Makerfabs/Home-Assistant-Relay-8-Channel/md_pic/main.jpg

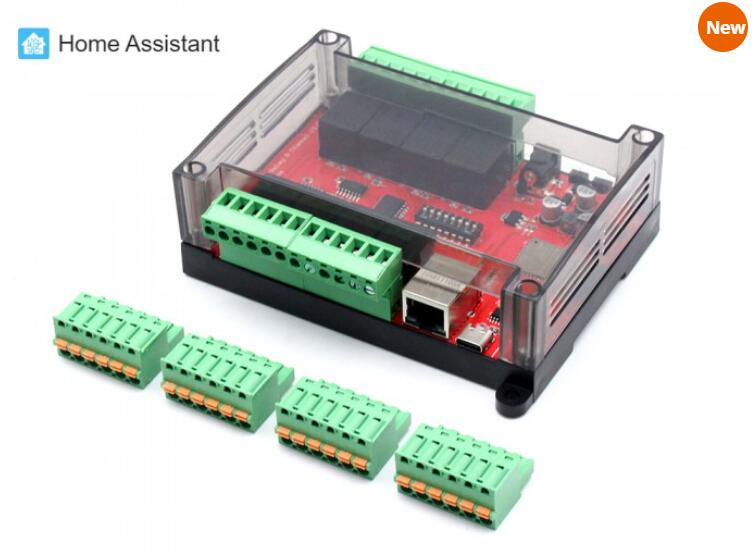
md_pic/main.jpg
