Makerfabs/Home-Assistant-Relay-8-Channel/README.md

# Makerfabs Home Assistant Relay 8 Channel

## Intruduce
[Product Link](https://www.makerfabs.com/8-channel-relay-for-home-assistant.html)

[Wiki Link](https://wiki.makerfabs.com/How-to-use-Home-Assistant-Relay-8-Channel.html)
