Makerfabs/Home-Assistant-Relay-8-Channel/md_pic/4.jpg

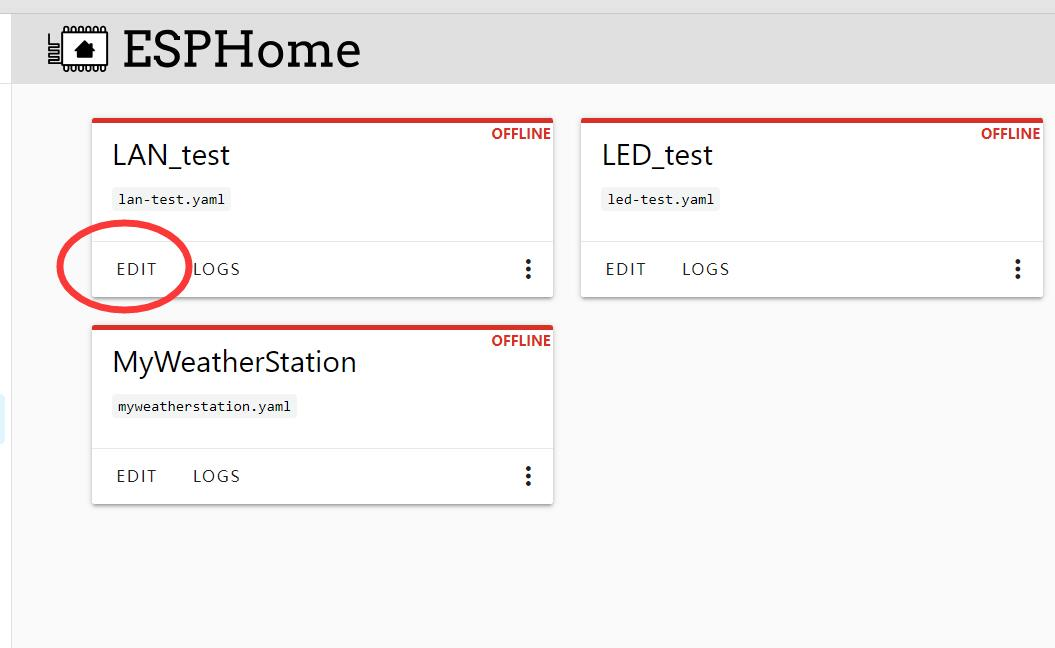
md_pic/4.jpg
