Makerfabs/Home-Assistant-Relay-8-Channel/md_pic/5.jpg

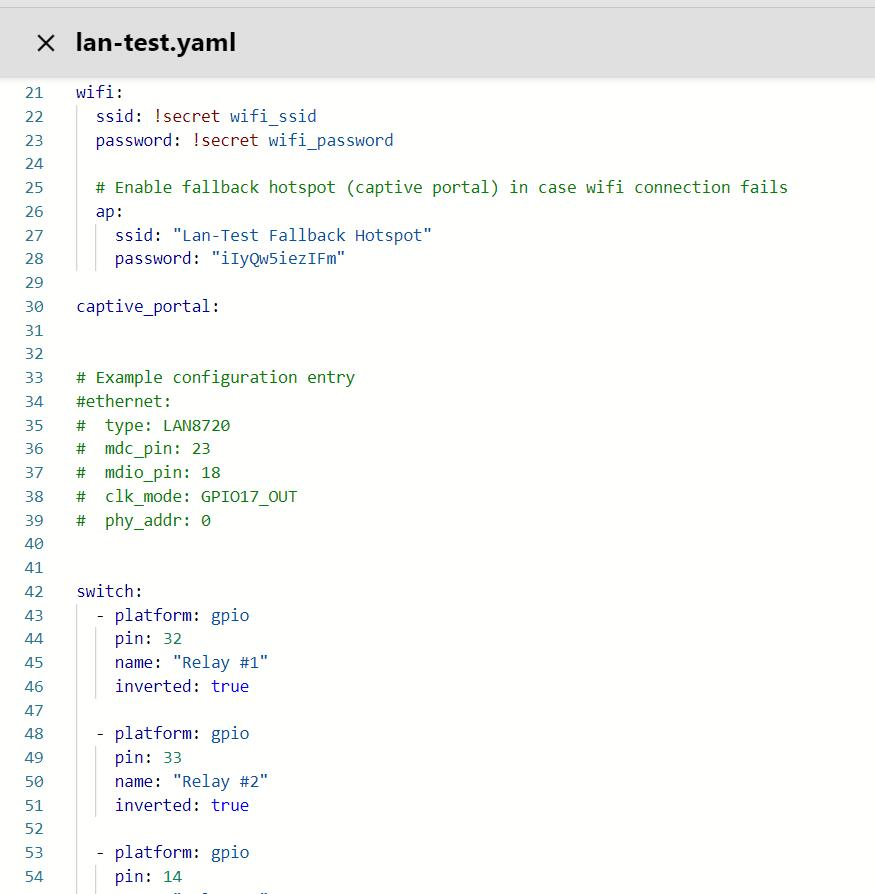
md_pic/5.jpg
