Makerfabs/Home-Assistant-Relay-8-Channel/md_pic/17.jpg

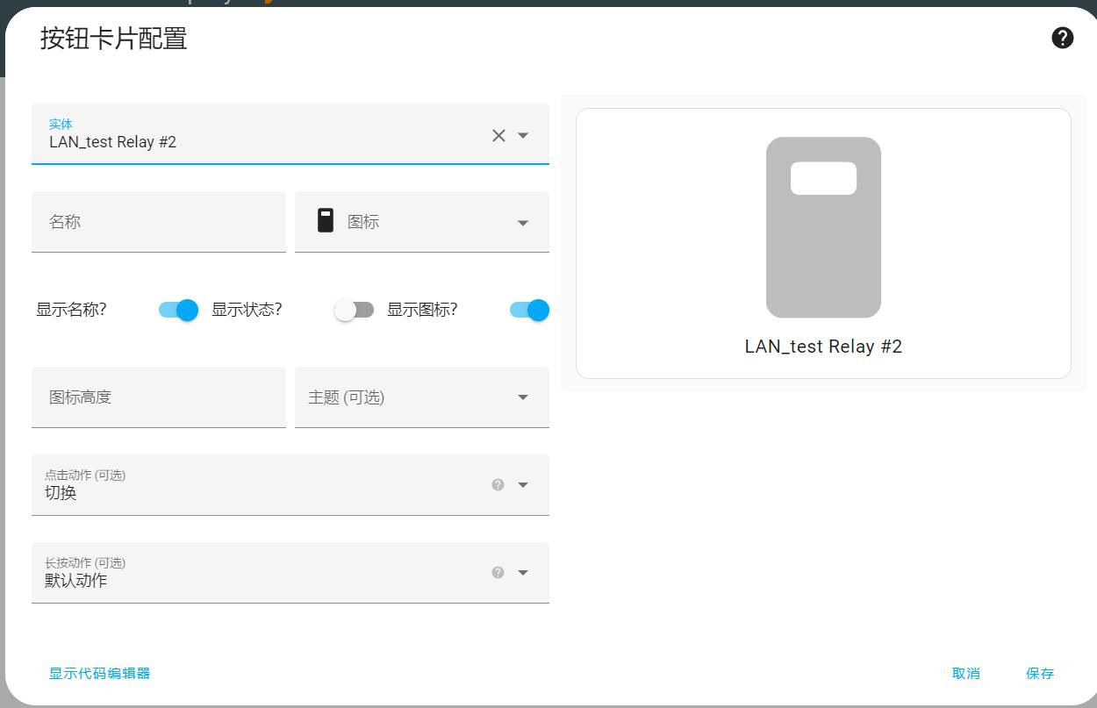
md_pic/17.jpg
