Makerfabs/Home-Assistant-Relay-8-Channel/md_pic/18.jpg

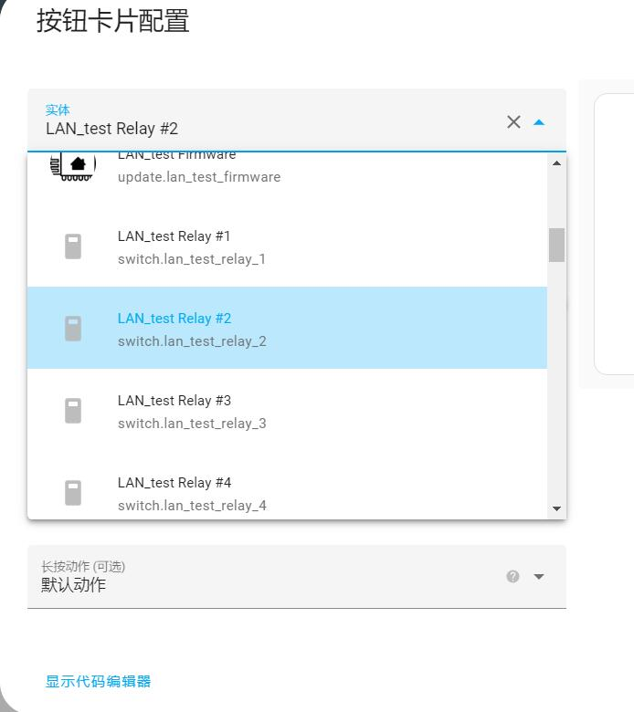
md_pic/18.jpg
