Makerfabs/Home-Assistant-Relay-8-Channel/md_pic/21.jpg

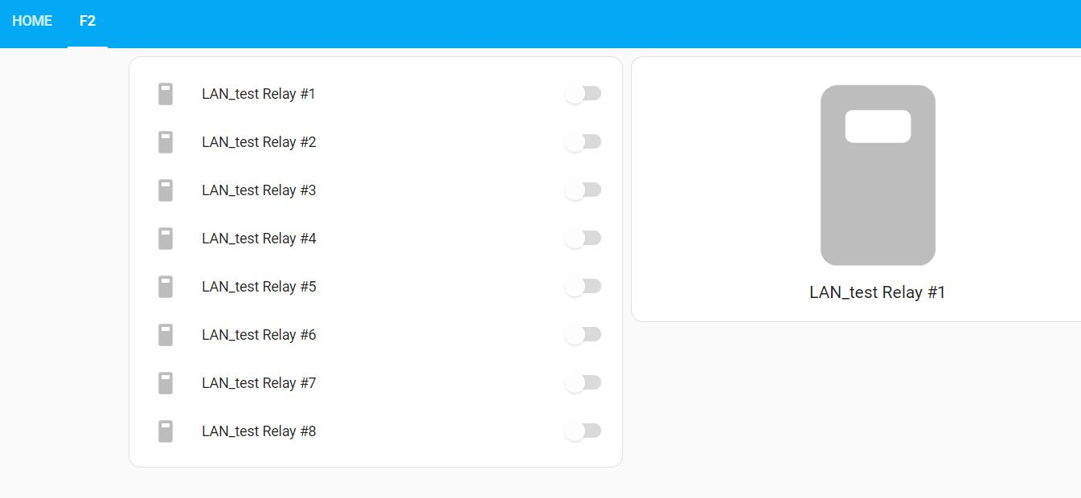
md_pic/21.jpg
