Makerfabs/Home-Assistant-Relay-8-Channel/hardware/Home Assistant Relay 8 Channel V1.2.pdf

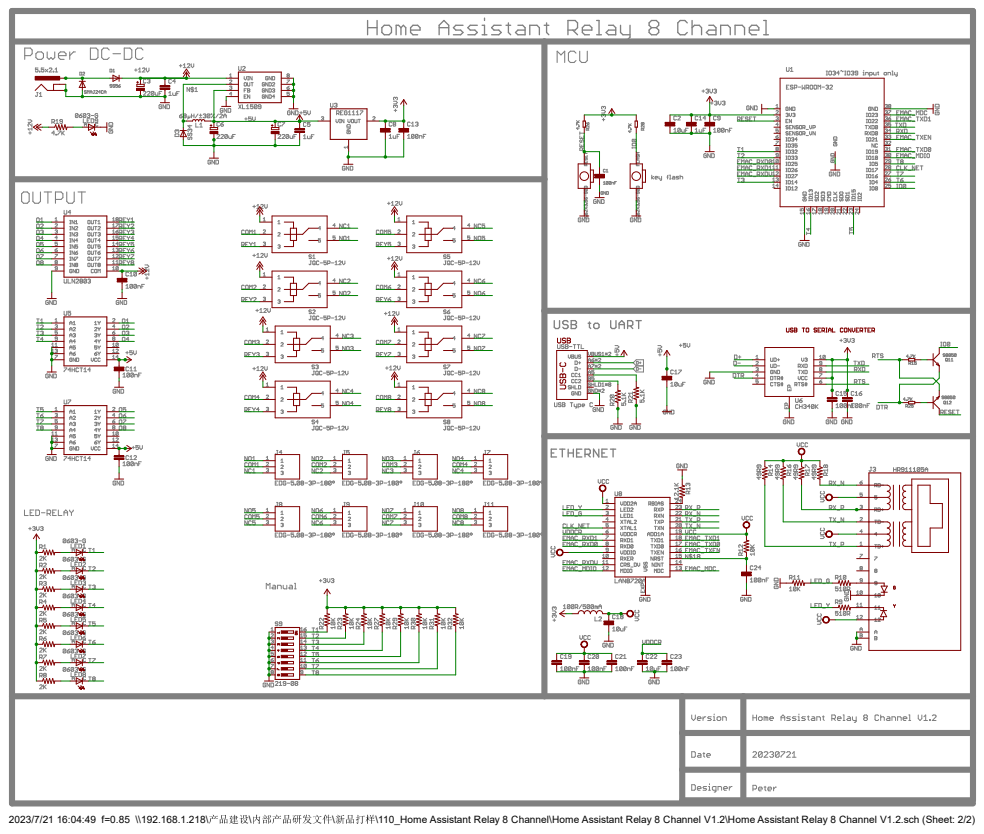
[picture p7: page 1]
\110_Home Assistant Relay 8 Channel\Home Assistant Relay 8 Channel V1.2\Home Assistant Relay 8 Channel V1.2.sch (Sheet: 2/2)
