Makerfabs/Home-Assistant-Relay-8-Channel/(threads)

Thread 1 (2023-10-11):

Add additional sensors

Misiu, 2023-10-11:
Hi there,
I was searching for a relay board that I can use with ESPHome and I found your board.
It looks great, but I have one additional question:
Do you allow/support additional sensors?
In my case I want to connect 5 DS18B20 sensors and one move sensor (simple input), so ideally I'd like to use your board to read the temperature and control the relays even when Home Assistant is unavailable.

poelzi, 2024-01-20:
I have a similar use case. For me, haveing some free pins that are currently NC on a pin header would be enough. I will just bodge my self up ;)

Misiu, 2024-01-21:
@195cn can we get any info on this issue? Thank you :)

195cn, 2024-01-22:
There is no additional GPIO for secondary development at the moment, I suggest sending an email directly to techsupport@makerfabs.com, so that my boss can see it and consider new products.    : )

Closed 2024-01-22.
