Makerfabs/Home-Assistant-Relay-8-Channel/(notices)

Notices in the files:
parts and their libraries:
SparkFun-Coils: Licensing: Creative Commons ShareAlike 4.0 International - https://creativecommons.org/licenses/by-sa/4.0
